gschreck/engine-monitor/hardware/can.sch

## KiCad design hardware/can.sch (2014-04-30)

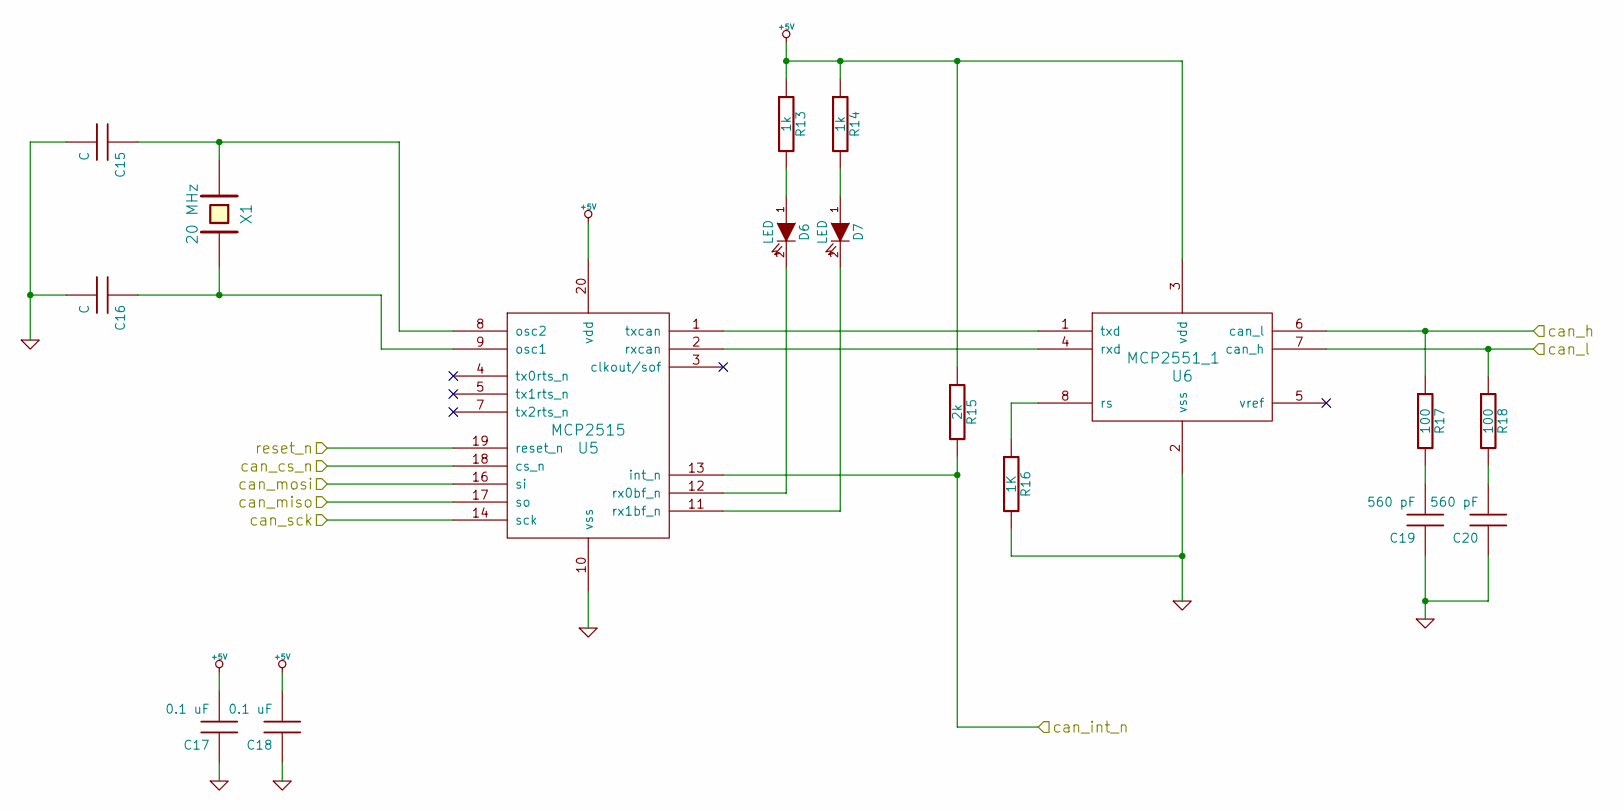
[picture p1: schematic can.sch]

Parts:
C15, C16: C
C17, C18: 0.1 uF
C19, C20: 560 pF
D6, D7: LED
R13, R14: 1k
R15: 2k
R16: 1K
R17, R18: 100
U5: MCP2515
U6: MCP2551_1
X1: 20 MHz

Connections:
+5V: C17.2, C18.2, R13.1, R14.1, R15.1, U5.20 (vdd), U6.3 (vdd)
GND: C15.2, C16.2, C17.1, C18.1, C19.1, C20.1, R16.2, U5.10 (vss), U6.2 (vss)
unnamed: C15.1, U5.8 (osc2), X1.1
unnamed: C16.1, U5.9 (osc1), X1.2
unnamed: C19.2, R17.2
unnamed: C20.2, R18.2
unnamed: D6.1 (A), R13.2
unnamed: D6.2 (K), U5.12 (rx0bf_n)
unnamed: D7.1 (A), R14.2
unnamed: D7.2 (K), U5.11 (rx1bf_n)
unnamed: R16.1, U6.8 (rs)
unnamed: U5.1 (txcan), U6.1 (txd)
unnamed: U5.2 (rxcan), U6.4 (rxd)
can_cs_n: U5.18 (cs_n)
can_h: R17.1, U6.6 (can_l)
can_int_n: R15.2, U5.13 (int_n)
can_l: R18.1, U6.7 (can_h)
can_miso: U5.17 (so)
can_mosi: U5.16 (si)
can_sck: U5.14 (sck)
reset_n: U5.19 (reset_n)
