gschreck/engine-monitor/hardware/gpio.sch

## KiCad design hardware/gpio.sch (2014-04-30)

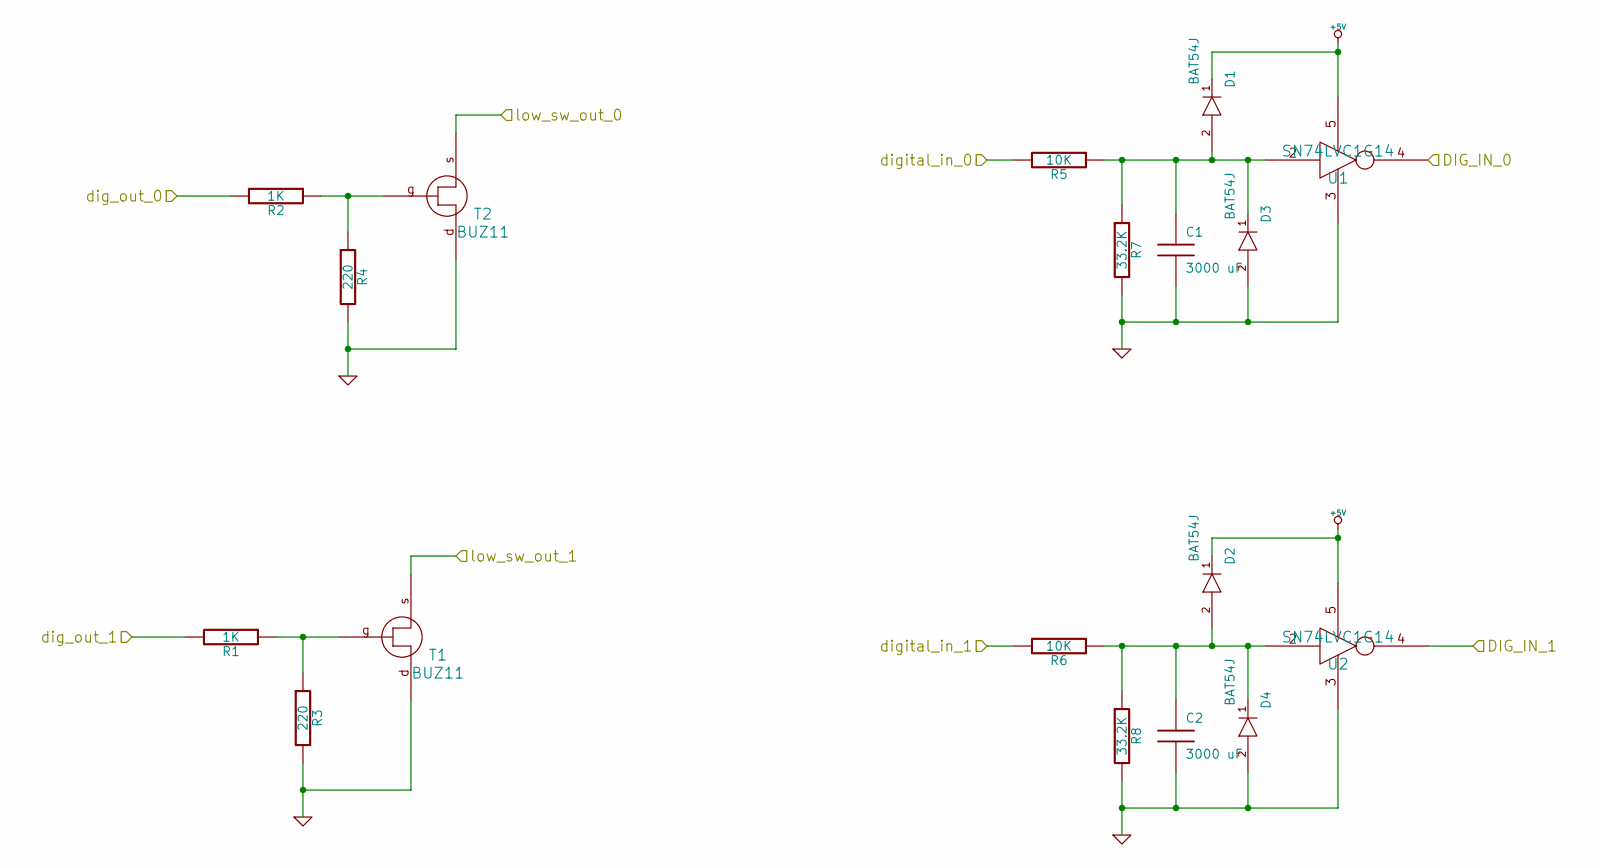
[picture p2: schematic gpio.sch]

Parts:
C1, C2: 3000 uF
D1, D2, D3, D4: BAT54J; 1206
R1, R2: 1K
R3, R4: 220
R5, R6: 10K
R7, R8: 33.2K
T1, T2: BUZ11
U1, U2: SN74LVC1G14

Connections:
+5V: D1.1, D2.1, U1.5, U2.5
DIG_IN_0: U1.4
DIG_IN_1: U2.4
GND: C1.2, C2.2, D3.2, D4.2, R3.2, R4.2, R7.2, R8.2, T1.d, T2.d, U1.3, U2.3
unnamed: C1.1, D1.2, D3.1, R5.1, R7.1, U1.2
unnamed: C2.1, D2.2, D4.1, R6.1, R8.1, U2.2
unnamed: R1.1, R3.1, T1.g
unnamed: R2.1, R4.1, T2.g
dig_out_0: R2.2
dig_out_1: R1.2
digital_in_0: R5.2
digital_in_1: R6.2
low_sw_out_0: T2.s
low_sw_out_1: T1.s
