gschreck/engine-monitor/hardware/in_out.sch

## KiCad design hardware/in_out.sch (2014-04-30)

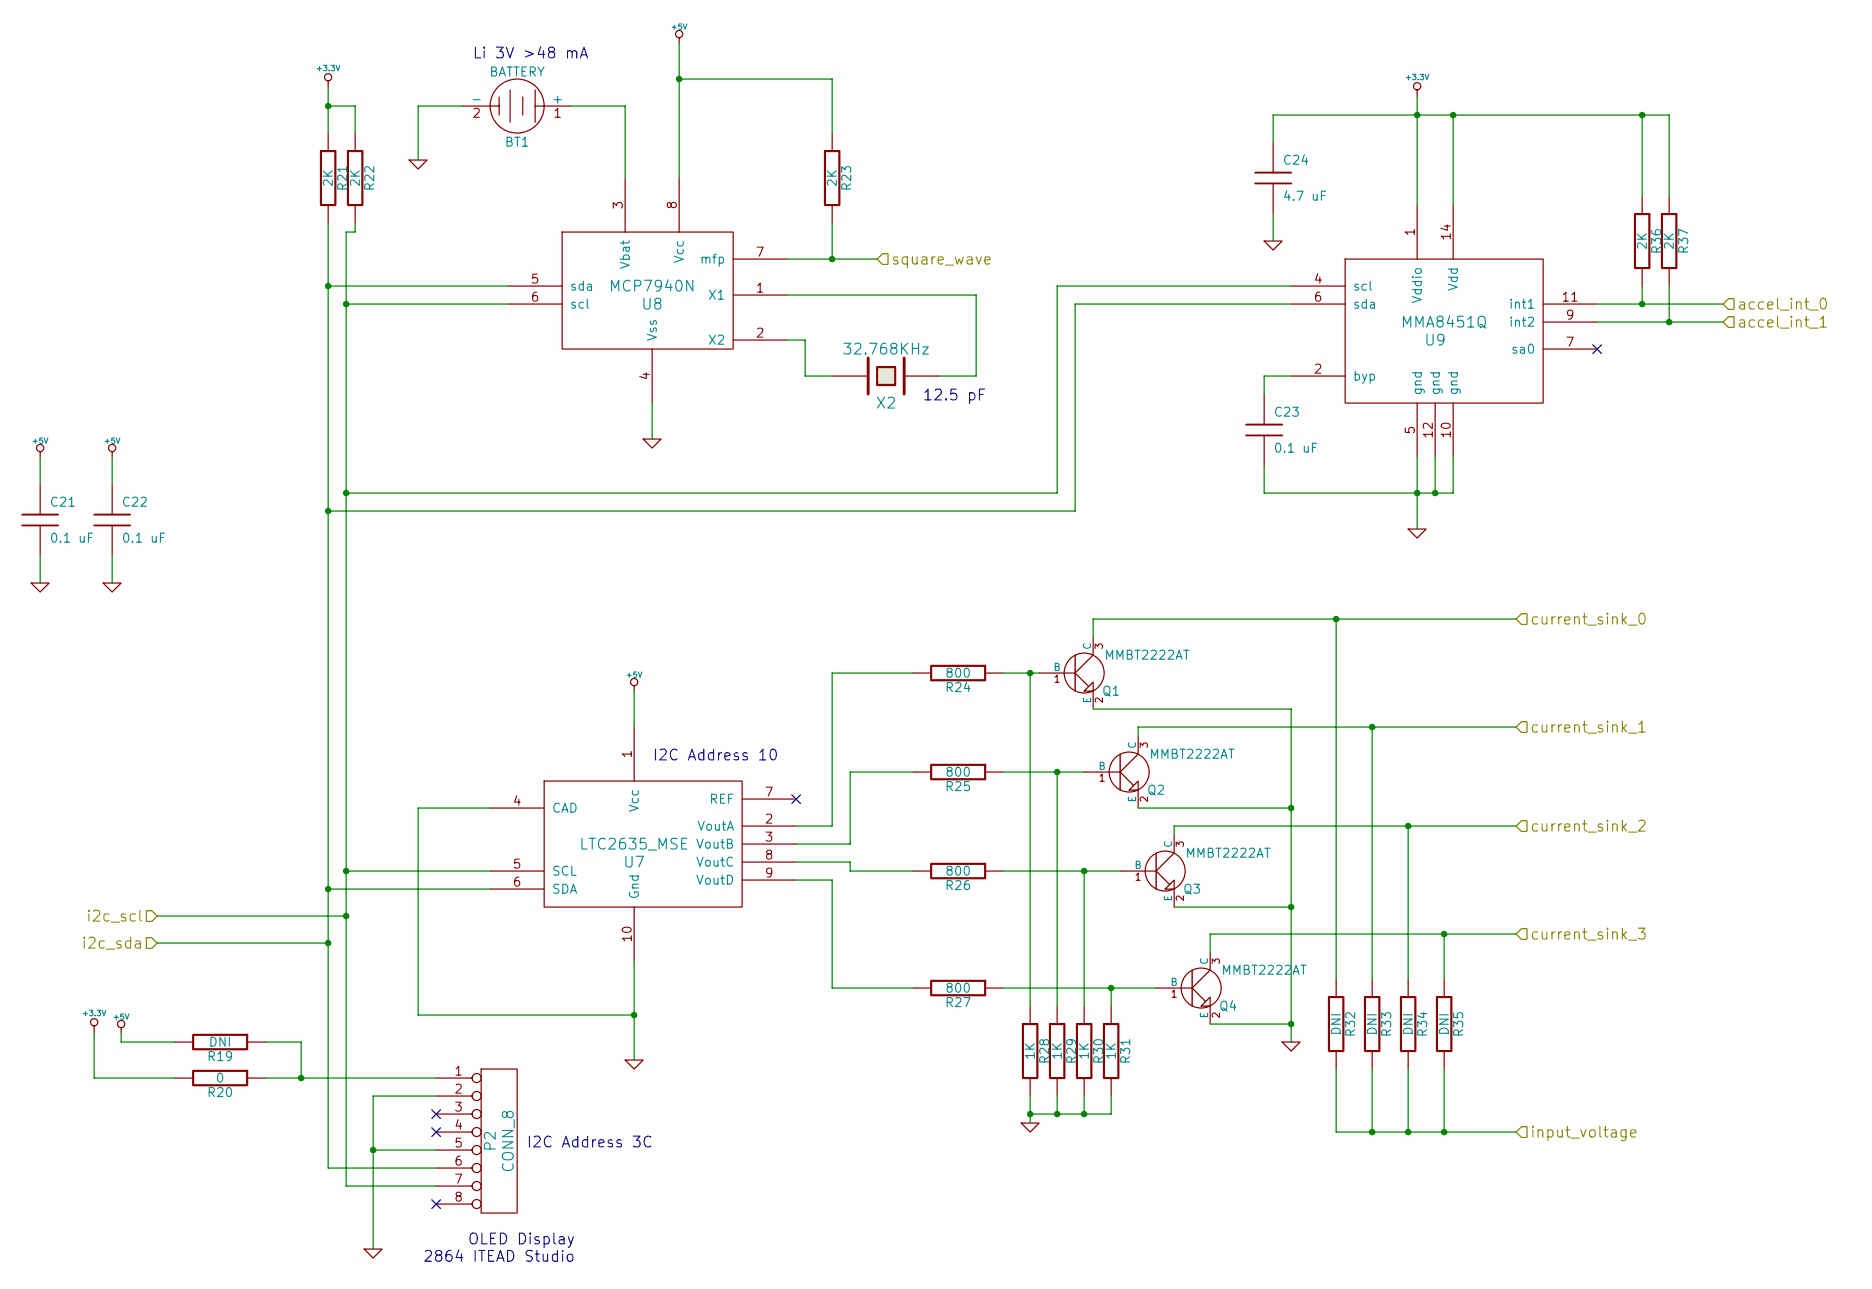
[picture p3: schematic in_out.sch]

Parts:
BT1: BATTERY
C21, C22, C23: 0.1 uF
C24: 4.7 uF
P2: CONN_8
Q1, Q2, Q3, Q4: MMBT2222AT; SOT-523
R19, R32, R33, R34, R35: DNI
R20: 0
R21, R22, R23, R36, R37: 2K
R24, R25, R26, R27: 800
R28, R29, R30, R31: 1K
U7: LTC2635_MSE
U8: MCP7940N
U9: MMA8451Q
X2: 32.768KHz

Connections:
+3.3V: C24.1, R20.2, R21.1, R22.1, R36.1, R37.1, U9.1 (Vddio), U9.14 (Vdd)
+5V: C21.1, C22.1, R19.2, R23.1, U7.1 (Vcc), U8.8 (Vcc)
GND: BT1.2 (-), C21.2, C22.2, C23.2, C24.2, P2.2, P2.5, Q1.2 (E), Q2.2 (E), Q3.2 (E), Q4.2 (E), R28.2, R29.2, R30.2, R31.2, U7.4 (CAD), U7.10 (Gnd), U8.4 (Vss), U9.5 (gnd), U9.10 (gnd), U9.12 (gnd)
unnamed: BT1.1 (+), U8.3 (Vbat)
unnamed: C23.1, U9.2 (byp)
unnamed: P2.1, R19.1, R20.1
unnamed: Q1.1 (B), R24.1, R28.1
unnamed: Q2.1 (B), R25.1, R29.1
unnamed: Q3.1 (B), R26.1, R30.1
unnamed: Q4.1 (B), R27.1, R31.1
unnamed: R24.2, U7.2 (VoutA)
unnamed: R25.2, U7.3 (VoutB)
unnamed: R26.2, U7.8 (VoutC)
unnamed: R27.2, U7.9 (VoutD)
unnamed: U8.1 (X1), X2.1
unnamed: U8.2 (X2), X2.2
accel_int_0: R36.2, U9.11 (int1)
accel_int_1: R37.2, U9.9 (int2)
current_sink_0: Q1.3 (C), R32.1
current_sink_1: Q2.3 (C), R33.1
current_sink_2: Q3.3 (C), R34.1
current_sink_3: Q4.3 (C), R35.1
i2c_scl: P2.7, R22.2, U7.5 (SCL), U8.6 (scl), U9.4 (scl)
i2c_sda: P2.6, R21.2, U7.6 (SDA), U8.5 (sda), U9.6 (sda)
input_voltage: R32.2, R33.2, R34.2, R35.2
square_wave: R23.2, U8.7 (mfp)

Notes on the sheet:
Li 3V >48 mA
12.5 pF
I2C Address 10
I2C Address 3C
OLED Display 2864 ITEAD Studio
