gschreck/engine-monitor/hardware/power.sch

## KiCad design hardware/power.sch (2014-04-30)

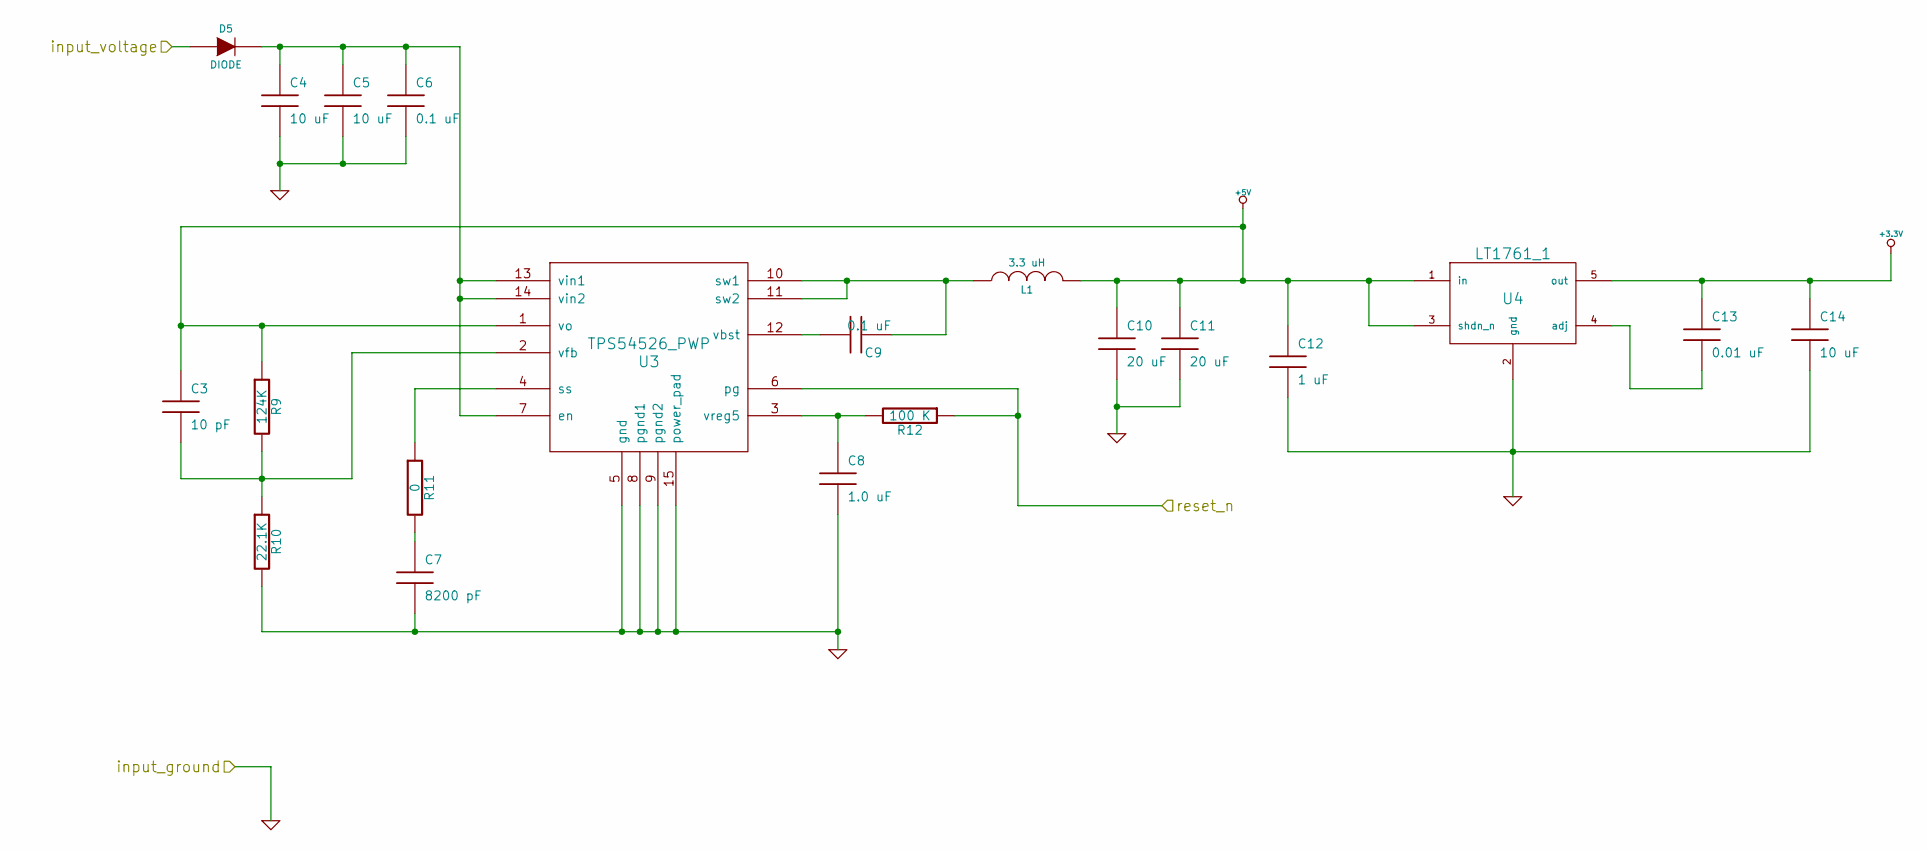
[picture p4: schematic power.sch]

Parts:
C3: 10 pF
C4, C5, C14: 10 uF
C6, C9: 0.1 uF
C7: 8200 pF
C8: 1.0 uF
C10, C11: 20 uF
C12: 1 uF
C13: 0.01 uF
D5: DIODE
L1: 3.3 uH
R9: 124K
R10: 22.1K
R11: 0
R12: 100 K
U3: TPS54526_PWP
U4: LT1761_1

Connections:
+3.3V: C13.1, C14.1, U4.5 (out)
+5V: C3.1, C10.1, C11.1, C12.1, L1.2, R9.1, U3.1 (vo), U4.1 (in), U4.3 (shdn_n)
GND: C4.2, C5.2, C6.2, C7.2, C8.2, C10.2, C11.2, C12.2, C14.2, R10.2, U3.5 (gnd), U3.8 (pgnd1), U3.9 (pgnd2), U3.15 (power_pad), U4.2 (gnd)
unnamed: C3.2, R9.2, R10.1, U3.2 (vfb)
unnamed: C4.1, C5.1, C6.1, D5.2 (K), U3.7 (en), U3.13 (vin1), U3.14 (vin2)
unnamed: C7.1, R11.2
unnamed: C8.1, R12.2, U3.3 (vreg5)
unnamed: C9.1, U3.12 (vbst)
unnamed: C9.2, L1.1, U3.10 (sw1), U3.11 (sw2)
unnamed: C13.2, U4.4 (adj)
unnamed: R11.1, U3.4 (ss)
input_voltage: D5.1 (A)
reset_n: R12.1, U3.6 (pg)
