gschreck/engine-monitor/hardware/processor.sch

## KiCad design hardware/processor.sch (2014-04-28)

Schematic: processor.sch

Parts:
C22, C23, C24, C25, C26, C30: 0.1uF
C27, C28: 22 pF
C29: 1 uF
D9, D10: LED
J1: USB_2
P3: CONN_3X2
R44, R45: 22R
R46, R47, R48: 2k
R49: DNI
U10: ATMEGA32U4
X2: 16 MHz

Notes on the sheet:
3M 290805 Digi-Key 3M5607CT-NO
ISP Programming
