gschreck/engine-monitor/(commit log)

2013-10-31 rearranged some processor I/O pins and added LEDs
    [can.sch, eng_mon.sch, in_out.sch, power.sch, processor.sch]
2013-11-04 changed heirarchy labels, changed diode and inductor to standard library symbols
    [can.sch, eng_mon.sch, in_out.sch, power.sch, processor.sch]
2013-11-04 cleaned up most of the error check problems
    [can.sch, eng_mon.sch, in_out.sch, power.sch, processor.sch]
2013-11-05 changed power supply to a lower cost TI part. Still some DRC errors.
    [can.sch, eng_mon.sch, in_out.sch, power.sch, processor.sch]
2013-11-06 Added ISP Programming header for microcontroller
    [processor.sch]
2013-11-07 added over voltage an reverse voltage protection, fixed some DRC errors
    [can.sch, eng_mon.sch, in_out.sch, power.sch, processor.sch]
2013-11-07 changed net labels on spi from off sheet to local
    [processor.sch]
2013-11-13 added RCT and accellerometer, added new sheet
    [can.sch, eng_mon.sch, in_out.sch, power.sch, processor.sch]
2013-11-13 new sheet added
    [gpio.sch]
2013-11-13 fixed heirarchy connections for modified sheets
    [can.sch, eng_mon.sch, gpio.sch, in_out.sch, power.sch, processor.sch]
2013-12-30 removed jtag header and changed the rtc
    [can.sch, eng_mon.sch, gpio.sch, in_out.sch, power.sch, processor.sch]
2014-03-04 removed some protection
    [power.sch]
2014-03-04 timestamps only
    [can.sch, eng_mon.sch, gpio.sch, in_out.sch, processor.sch]
2014-04-28 updated schematics to include new library and added uSD drive to processor
    [can.sch, eng_mon.sch, gpio.sch, in_out.sch, power.sch, processor.sch]
2014-04-30 fixed some ERCs and simplified reset
    [can.sch, eng_mon.sch, gpio.sch, in_out.sch, power.sch]
